pkrish11/PDL-Autoclave-DAQ-PCB/Rev2_AutoclaveDAQ.csv

Reference | Qty | Value | DNP | Exclude from BOM | Exclude from Board | Exclude from Simulation | Exclude from Position Files | Footprint | Datasheet | DigiKey_Part_Number | Quantity
C1,C3,C4 | 3 | 10u |  |  |  |  | ${EXCLUDE_FROM_POS_FILES} | Capacitor_SMD:C_0805_2012Metric | https://mm.digikey.com/Volume0/opasdata/d220001/medias/docus/926/CL_Series_MLCC_ds.pdf | 1276-2872-1-ND | 8
C2,C6,C8,C10,C11,C12 | 6 | 0.1u |  |  |  |  | ${EXCLUDE_FROM_POS_FILES} | Capacitor_SMD:C_0805_2012Metric | https://yageogroup.com/content/datasheet/asset/file/KEM_C1002_X7R_SMD | 399-C0805C104K5RACTUCT-ND | 14
C5,C7,C9 | 3 | 0.22u |  |  |  |  | ${EXCLUDE_FROM_POS_FILES} | Capacitor_SMD:C_0805_2012Metric | https://yageogroup.com/content/datasheet/asset/file/KEM_C1002_X7R_SMD | 399-C0805C224K5RACTUCT-ND | 8
F1,F2 | 2 | Fuseholders |  |  |  |  | ${EXCLUDE_FROM_POS_FILES} | Fuse:Fuseholder_Cylinder-5x20mm_Wuerth_696103101002-SMD_Horizontal_Open | https://www.we-online.com/catalog/datasheet/696108003002.pdf | 732-11376-ND | 5
J1,J6,J7,J8 | 4 | Pressure Sense Connector,RTD1 Connector,RTD2 Connector,RTD3 Connector |  |  |  |  | ${EXCLUDE_FROM_POS_FILES} | Connector_JST:JST_XH_B4B-XH-A_1x04_P2.50mm_Vertical | https://www.jst-mfg.com/product/pdf/eng/eXH.pdf | 455-B4B-XH-A-ND | 10
J2,J3,J4 | 3 | Relay1 Con,Relay2 Con,Relay3 Con |  |  |  |  | ${EXCLUDE_FROM_POS_FILES} | Connector_JST:JST_XH_B3B-XH-A_1x03_P2.50mm_Vertical | https://www.jst-mfg.com/product/pdf/eng/eXH.pdf | 455-2248-ND | 8
J5,J9,J10 | 3 | PowerIn Con,Valve1 PowerCon,Valve2 Power Con |  |  |  |  | ${EXCLUDE_FROM_POS_FILES} | Connector_JST:JST_XH_B2B-XH-A_1x02_P2.50mm_Vertical | https://www.jst-mfg.com/product/pdf/eng/eXH.pdf | 455-B2B-XH-A-ND | 8
PS1 | 1 | R-78K5.0-2.0L |  |  |  |  | ${EXCLUDE_FROM_POS_FILES} | PDL_kicad_footprints:CONV_R-78K5.0-2.0L |  | 945-R-78K5.0-2.0L-ND | 2
R1,R2,R3,R4,R5,R6 | 6 | 10k |  |  |  |  | ${EXCLUDE_FROM_POS_FILES} | Resistor_SMD:R_0805_2012Metric | https://www.seielect.com/catalog/SEI-RMCF_RMCP.pdf | RMCF0805FT10K0CT-ND | 14
R7,R12 | 2 | 100k |  |  |  |  | ${EXCLUDE_FROM_POS_FILES} | Resistor_SMD:R_0805_2012Metric | https://industrial.panasonic.com/cdbs/www-data/pdf/RDM0000/AOA0000C307.pdf | P100KDACT-ND | 6
R8 | 1 | 1k |  |  |  |  | ${EXCLUDE_FROM_POS_FILES} | Resistor_SMD:R_0805_2012Metric | https://www.vishay.com/docs/20035/dcrcwe3.pdf | 541-1.00KCCT-ND | 4
R9,R10,R11 | 3 | 4k |  |  |  |  | ${EXCLUDE_FROM_POS_FILES} | Resistor_SMD:R_0805_2012Metric | https://www.seielect.com/catalog/SEI-RNCF.pdf | 738-RNCF0805BTY4K00CT-ND | 8
S1 | 1 | Crimp Attachments |  |  | Excluded from board | Excluded from simulation | ${EXCLUDE_FROM_POS_FILES} |  | https://www.jst-mfg.com/product/pdf/eng/eXH.pdf | 455-1135TR-ND | 50
S2 | 1 | 3 Pin Adapter |  |  | Excluded from board | Excluded from simulation | ${EXCLUDE_FROM_POS_FILES} |  |  | 455-2219-ND | 10
S3 | 1 | 2 Pin Adapter |  |  | Excluded from board | Excluded from simulation | ${EXCLUDE_FROM_POS_FILES} |  |  | 455-2266-ND | 10
S4 | 1 | 4 Pin Adapter |  |  | Excluded from board | Excluded from simulation | ${EXCLUDE_FROM_POS_FILES} |  |  | 455-2267-ND | 10
U2,U3,U4 | 3 | MAX31865AAP+ |  |  |  |  | ${EXCLUDE_FROM_POS_FILES} | PDL_kicad_footprints:21-0056C_20_MXM-M | MAX31865AAP+ | MAX31865AAP+ | 3
 |  | Num Boards =2
