pkrish11/PDL-Autoclave-DAQ-PCB/Rev2_AutoclaveDAQ.kicad_pcb

## KiCad design Rev2_AutoclaveDAQ.kicad_pcb (2026-11-10)

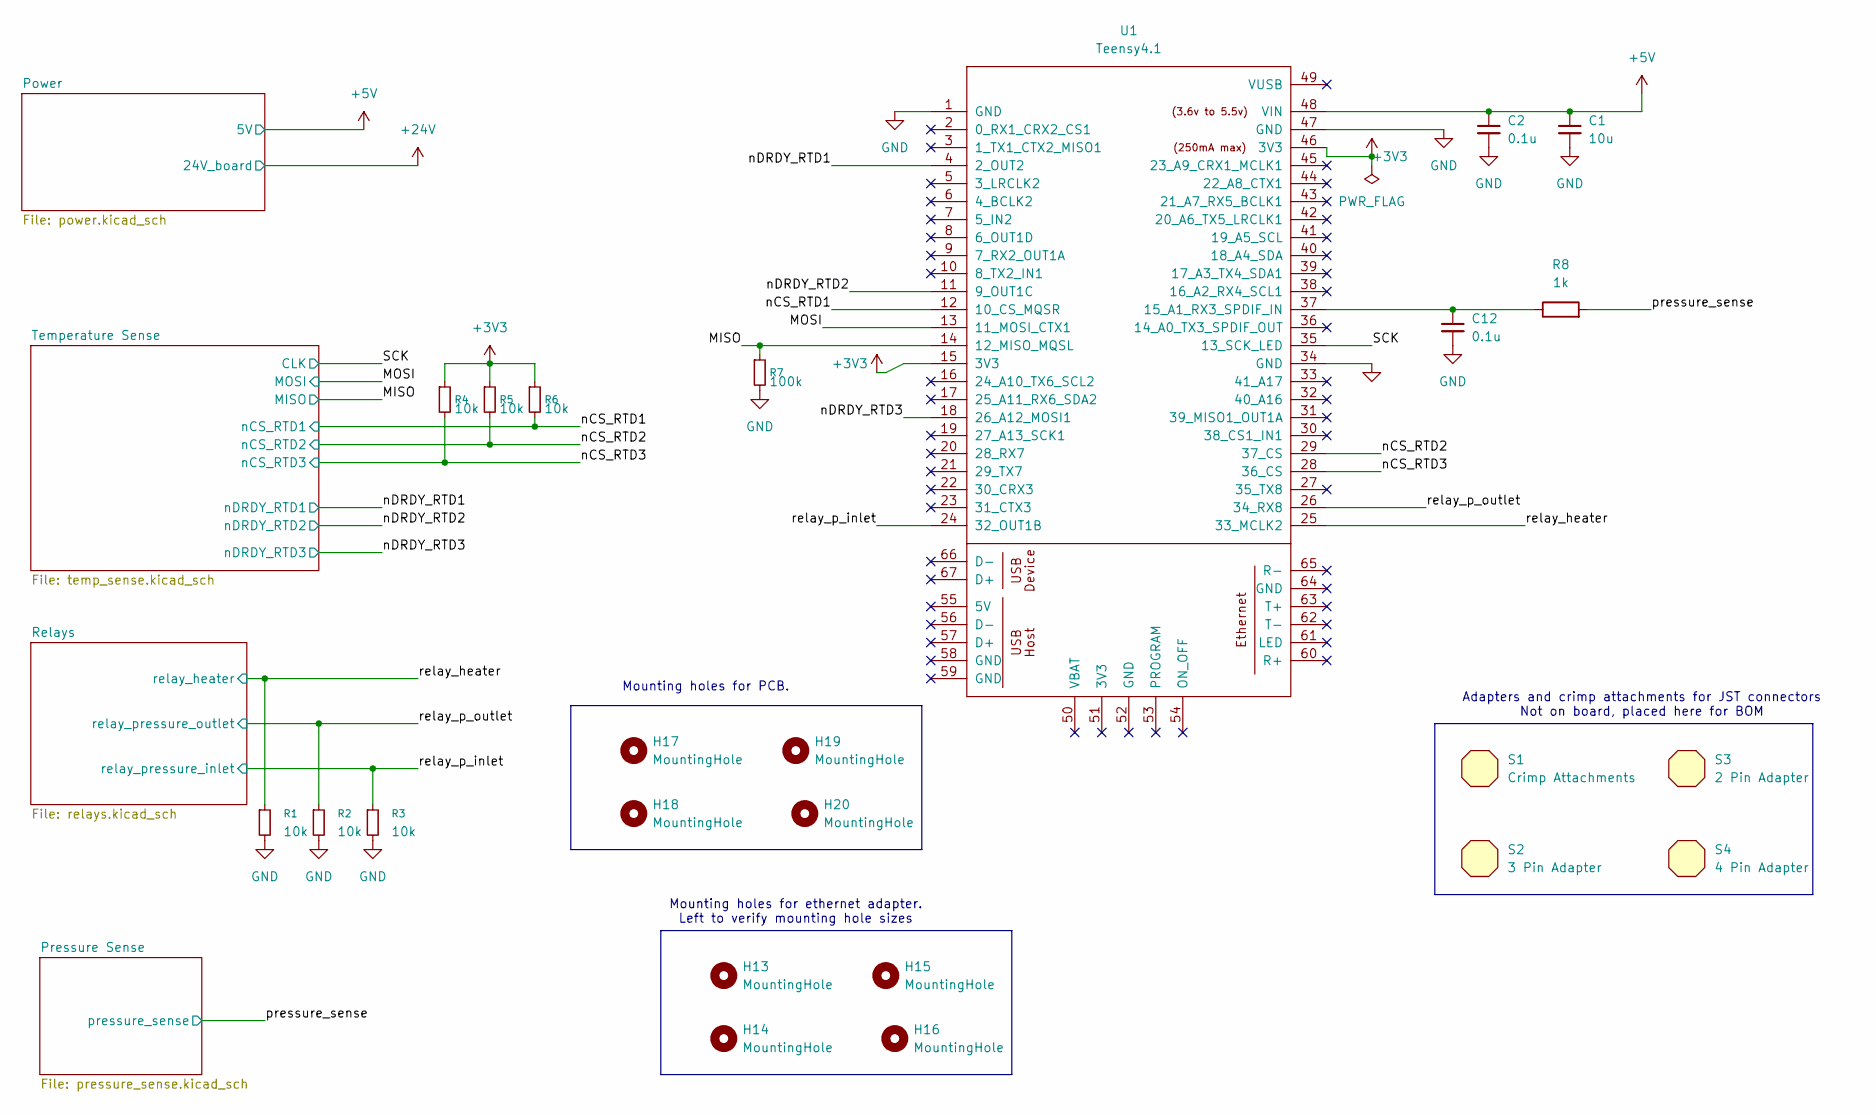
[picture p1: schematic Rev2_AutoclaveDAQ.kicad_sch, Autoclave DAQ Version 2]

Parts:
C1: 10u; C_0805_2012Metric; DigiKey_Part_Number 1276-2872-1-ND
C2, C12: 0.1u; C_0805_2012Metric; DigiKey_Part_Number 399-C0805C104K5RACTUCT-ND
H13, H14, H15, H16, H17, H18, H19, H20: MountingHole; MountingHole_3.2mm_M3
R1, R2, R3, R4, R5, R6: 10k; R_0805_2012Metric; DigiKey_Part_Number RMCF0805FT10K0CT-ND
R7: 100k; R_0805_2012Metric; DigiKey_Part_Number P100KDACT-ND
R8: 1k; R_0805_2012Metric; DigiKey_Part_Number 541-1.00KCCT-ND
S1: Crimp Attachments; DigiKey_Part_Number 455-1135TR-ND
S2: 3 Pin Adapter; DigiKey_Part_Number 455-2219-ND
S3: 2 Pin Adapter; DigiKey_Part_Number 455-2266-ND
S4: 4 Pin Adapter; DigiKey_Part_Number 455-2267-ND
U1: Teensy4.1; Teensy41

Connections:
+3V3: R4.1, R5.1, R6.1, U1.15 (3V3), U1.46 (3V3); also elsewhere on the board
+5V: C1.1, C2.1, U1.48 (VIN); also elsewhere on the board
/MISO: R7.1, U1.14 (12_MISO_MQSL); also elsewhere on the board
/MOSI: U1.13 (11_MOSI_CTX1); also elsewhere on the board
/SCK: U1.35 (13_SCK_LED); also elsewhere on the board
/nCS_RTD1: R6.2, U1.12 (10_CS_MQSR); also elsewhere on the board
/nCS_RTD2: R5.2, U1.29 (37_CS); also elsewhere on the board
/nCS_RTD3: R4.2, U1.28 (36_CS); also elsewhere on the board
/nDRDY_RTD1: U1.4 (2_OUT2); also elsewhere on the board
/nDRDY_RTD2: U1.11 (9_OUT1C); also elsewhere on the board
/nDRDY_RTD3: U1.18 (26_A12_MOSI1); also elsewhere on the board
/pressure_sense: R8.2; also elsewhere on the board
/relay_heater: R1.1, U1.25 (33_MCLK2); also elsewhere on the board
/relay_p_inlet: R3.1, U1.24 (32_OUT1B); also elsewhere on the board
/relay_p_outlet: R2.1, U1.26 (34_RX8); also elsewhere on the board
GND: C1.2, C2.2, C12.2, R1.2, R2.2, R3.2, R7.2, U1.1 (GND), U1.34 (GND), U1.47 (GND); also elsewhere on the board
unnamed: C12.1, R8.1, U1.37 (15_A1_RX3_SPDIF_IN)

Notes on the sheet:
Adapters and crimp attachments for JST connectors Not on board, placed here for BOM
Mounting holes for ethernet adapter. Left to verify mounting hole sizes
Mounting holes for PCB.

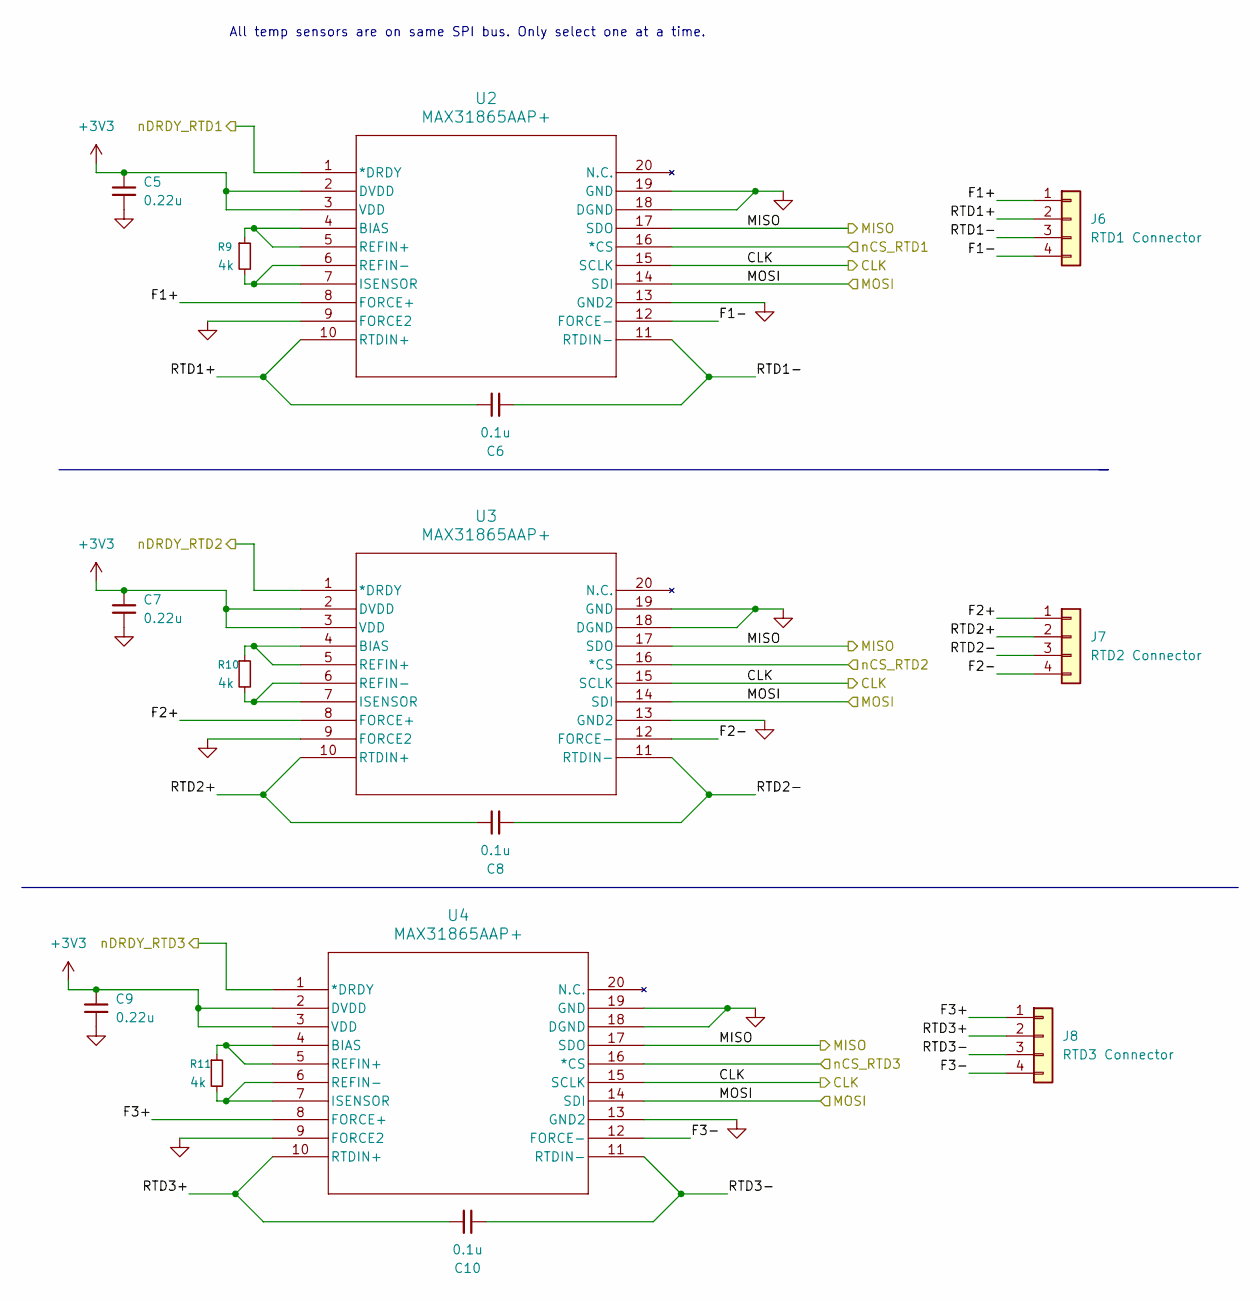
[picture p2: schematic temp_sense.kicad_sch]

Parts:
C5, C7, C9: 0.22u; C_0805_2012Metric; DigiKey_Part_Number 399-C0805C224K5RACTUCT-ND
C6, C8, C10: 0.1u; C_0805_2012Metric; DigiKey_Part_Number 399-C0805C104K5RACTUCT-ND
J6: RTD1 Connector; JST_XH_B4B-XH-A_1x04_P2.50mm_Vertical; DigiKey_Part_Number 455-B4B-XH-A-ND
J7: RTD2 Connector; JST_XH_B4B-XH-A_1x04_P2.50mm_Vertical; DigiKey_Part_Number 455-B4B-XH-A-ND
J8: RTD3 Connector; JST_XH_B4B-XH-A_1x04_P2.50mm_Vertical; DigiKey_Part_Number 455-B4B-XH-A-ND
R9, R10, R11: 4k; R_0805_2012Metric; DigiKey_Part_Number 738-RNCF0805BTY4K00CT-ND
U2, U3, U4: MAX31865AAP+; 21-0056C_20_MXM-M; DigiKey_Part_Number MAX31865AAP+

Connections:
+3V3: C5.1, C7.1, C9.1, U2.2 (DVDD), U2.3 (VDD), U3.2 (DVDD), U3.3 (VDD), U4.2 (DVDD), U4.3 (VDD); also elsewhere on the board
/MISO: U2.17 (SDO), U3.17 (SDO), U4.17 (SDO); also elsewhere on the board
/MOSI: U2.14 (SDI), U3.14 (SDI), U4.14 (SDI); also elsewhere on the board
/SCK: U2.15 (SCLK), U3.15 (SCLK), U4.15 (SCLK); also elsewhere on the board
/Temperature Sense/F1+: J6.1, U2.8 (FORCE+)
/Temperature Sense/F1-: J6.4, U2.12 (FORCE-)
/Temperature Sense/F2+: J7.1, U3.8 (FORCE+)
/Temperature Sense/F2-: J7.4, U3.12 (FORCE-)
/Temperature Sense/F3+: J8.1, U4.8 (FORCE+)
/Temperature Sense/F3-: J8.4, U4.12 (FORCE-)
/Temperature Sense/RTD1+: C6.1, J6.2, U2.10 (RTDIN+)
/Temperature Sense/RTD1-: C6.2, J6.3, U2.11 (RTDIN-)
/Temperature Sense/RTD2+: C8.1, J7.2, U3.10 (RTDIN+)
/Temperature Sense/RTD2-: C8.2, J7.3, U3.11 (RTDIN-)
/Temperature Sense/RTD3+: C10.1, J8.2, U4.10 (RTDIN+)
/Temperature Sense/RTD3-: C10.2, J8.3, U4.11 (RTDIN-)
/nCS_RTD1: U2.16 (*CS); also elsewhere on the board
/nCS_RTD2: U3.16 (*CS); also elsewhere on the board
/nCS_RTD3: U4.16 (*CS); also elsewhere on the board
/nDRDY_RTD1: U2.1 (*DRDY); also elsewhere on the board
/nDRDY_RTD2: U3.1 (*DRDY); also elsewhere on the board
/nDRDY_RTD3: U4.1 (*DRDY); also elsewhere on the board
GND: C5.2, C7.2, C9.2, U2.9 (FORCE2), U2.13 (GND2), U2.18 (DGND), U2.19 (GND), U3.9 (FORCE2), U3.13 (GND2), U3.18 (DGND), U3.19 (GND), U4.9 (FORCE2), U4.13 (GND2), U4.18 (DGND), U4.19 (GND); also elsewhere on the board
unnamed: R9.1, U2.4 (BIAS), U2.5 (REFIN+)
unnamed: R9.2, U2.6 (REFIN-), U2.7 (ISENSOR)
unnamed: R10.1, U3.4 (BIAS), U3.5 (REFIN+)
unnamed: R10.2, U3.6 (REFIN-), U3.7 (ISENSOR)
unnamed: R11.1, U4.4 (BIAS), U4.5 (REFIN+)
unnamed: R11.2, U4.6 (REFIN-), U4.7 (ISENSOR)

Notes on the sheet:
All temp sensors are on same SPI bus. Only select one at a time.

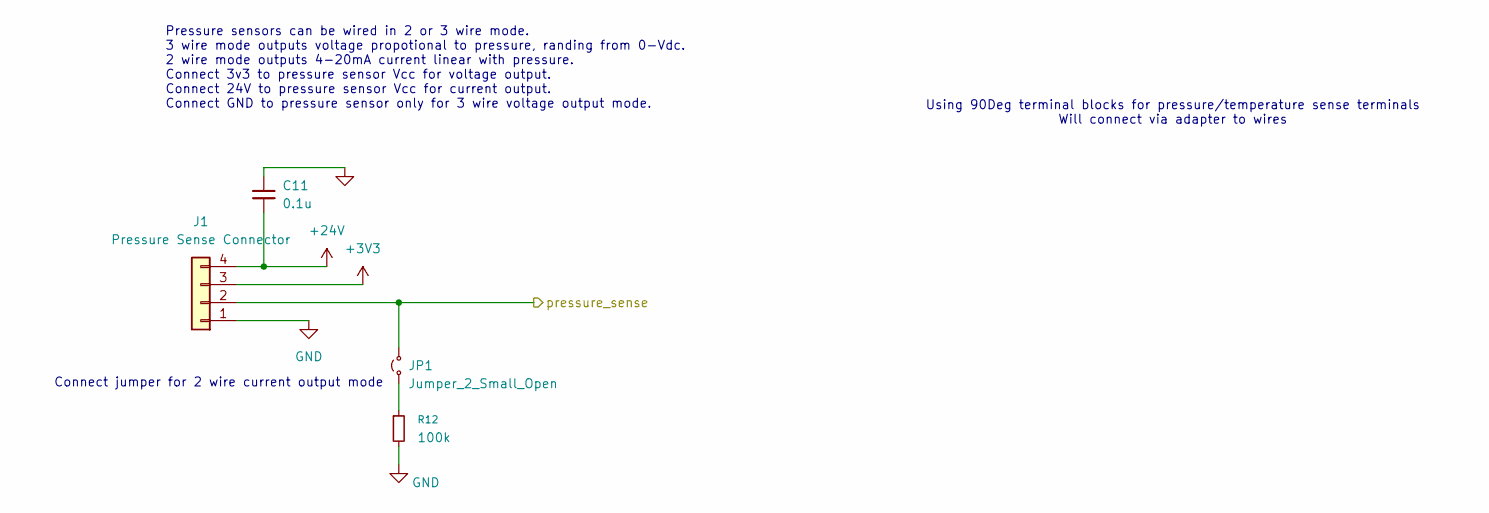
[picture p3: schematic pressure_sense.kicad_sch]

Parts:
C11: 0.1u; C_0805_2012Metric; DigiKey_Part_Number 399-C0805C104K5RACTUCT-ND
J1: Pressure Sense Connector; JST_XH_B4B-XH-A_1x04_P2.50mm_Vertical; DigiKey_Part_Number 455-B4B-XH-A-ND
JP1: Jumper_2_Small_Open; PinHeader_1x02_P2.54mm_Vertical
R12: 100k; R_0805_2012Metric; DigiKey_Part_Number P100KDACT-ND

Connections:
+3V3: J1.3; also elsewhere on the board
+24V: C11.2, J1.4; also elsewhere on the board
/pressure_sense: J1.2, JP1.2 (B); also elsewhere on the board
GND: C11.1, J1.1, R12.2; also elsewhere on the board
unnamed: JP1.1 (A), R12.1

Notes on the sheet:
Connect jumper for 2 wire current output mode
Using 90Deg terminal blocks for pressure/temperature sense terminals Will connect via adapter to wires
Pressure sensors can be wired in 2 or 3 wire mode. 3 wire mode outputs voltage propotional to pressure, randing from 0-Vdc. 2 wire mode outputs 4-20mA current linear with pressure. Connect 3v3 to pressure sensor Vcc for voltage output. Connect 24V to pressure sensor Vcc for current output. Connect 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

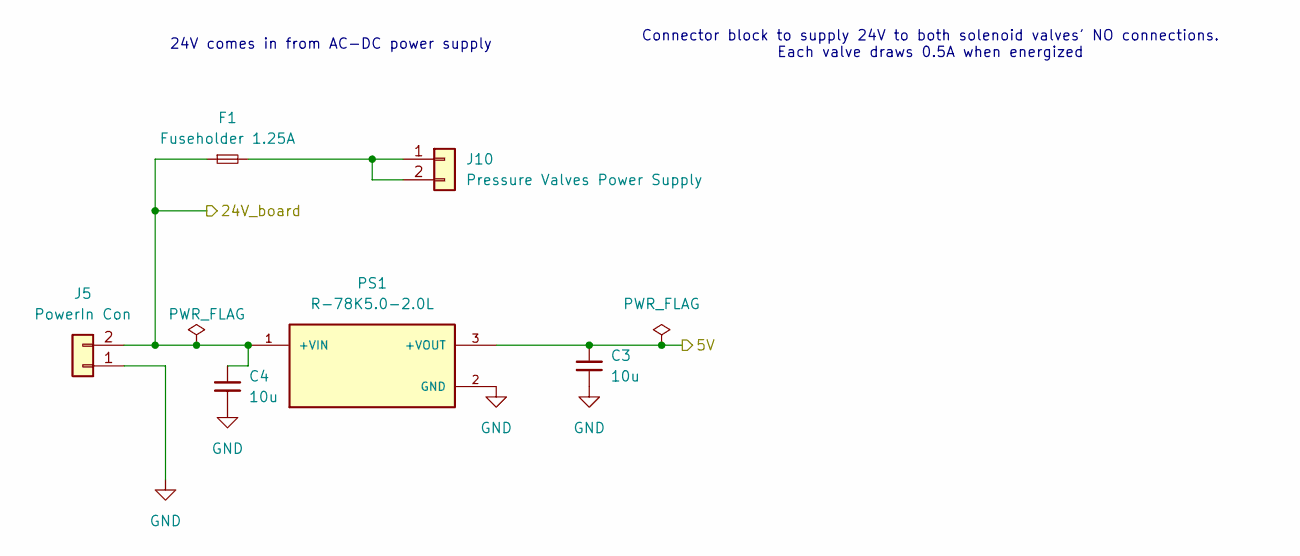
[picture p4: schematic power.kicad_sch]

Parts:
C3, C4: 10u; C_0805_2012Metric; DigiKey_Part_Number 1276-2872-1-ND
F1: Fuseholder 1.25A; Fuseholder_Cylinder-5x20mm_Wuerth_696103101002-SMD_Horizont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; DigiKey_Part_Number 732-11376-ND
J5: PowerIn Con; JST_XH_B2B-XH-A_1x02_P2.50mm_Vertical; DigiKey_Part_Number 455-B2B-XH-A-ND
J10: Pressure Valves Power Supply; JST_XH_B2B-XH-A_1x02_P2.50mm_Vertical; DigiKey_Part_Number 455-B2B-XH-A-ND
PS1: R-78K5.0-2.0L; CONV_R-78K5.0-2.0L; PARTREV 1; DigiKey_Part_Number 945-R-78K5.0-2.0L-ND

Connections:
+5V: C3.1, PS1.3 (+VOUT); also elsewhere on the board
+24V: C4.1, F1.1, J5.2, PS1.1 (+VIN); also elsewhere on the board
GND: C3.2, C4.2, J5.1, PS1.2 (GND); also elsewhere on the board
unnamed: F1.2, J10.1, J10.2

Notes on the sheet:
24V comes in from AC-DC power supply
Connector block to supply 24V to both solenoid valves' NO connections. Each valve draws 0.5A when energized

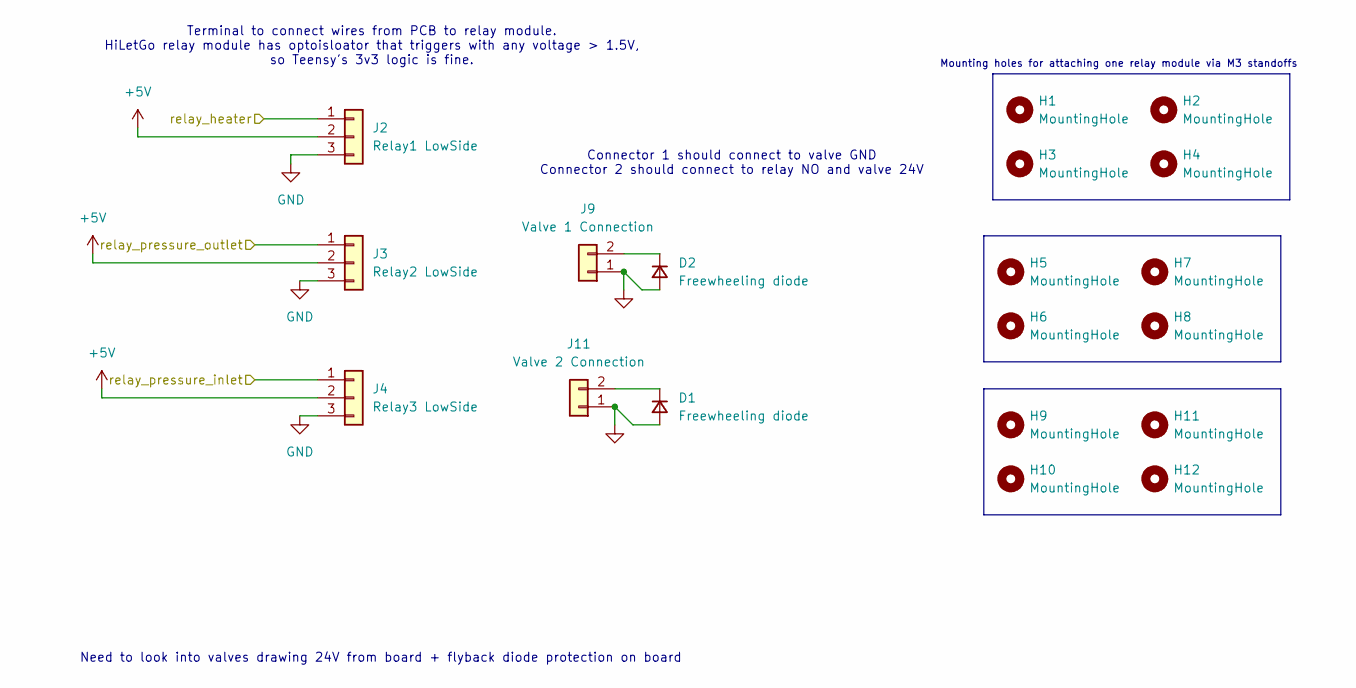
[picture p5: schematic relays.kicad_sch]

Parts:
D1, D2: Freewheeling diode; SMA_403AE_OSI-L
H1, H2, H3, H4, H5, H6, H7, H8, H9, H10, H11, H12: MountingHole; MountingHole_3.2mm_M3
J2: Relay1 LowSide; JST_XH_B3B-XH-A_1x03_P2.50mm_Vertical; DigiKey_Part_Number 455-2248-ND
J3: Relay2 LowSide; JST_XH_B3B-XH-A_1x03_P2.50mm_Vertical; DigiKey_Part_Number 455-2248-ND
J4: Relay3 LowSide; JST_XH_B3B-XH-A_1x03_P2.50mm_Vertical; DigiKey_Part_Number 455-2248-ND
J9: Valve 1 Connection; JST_XH_B2B-XH-A_1x02_P2.50mm_Vertical
J11: Valve 2 Connection; JST_XH_B2B-XH-A_1x02_P2.50mm_Vertical

Connections:
+5V: J2.2, J3.2, J4.2; also elsewhere on the board
/relay_heater: J2.1; also elsewhere on the board
/relay_p_inlet: J4.1; also elsewhere on the board
/relay_p_outlet: J3.1; also elsewhere on the board
GND: D1.2 (A), D2.2 (A), J2.3, J3.3, J4.3, J9.1, J11.1; also elsewhere on the board
unnamed: D1.1 (K), J11.2
unnamed: D2.1 (K), J9.2

Notes on the sheet:
Mounting holes for attaching one relay module via M3 standoffs
Terminal to connect wires from PCB to relay module. HiLetGo relay module has optoisloator that triggers with any voltage > 1.5V, so Teensy's 3v3 logic is fine.
Need to look into valves drawing 24V from board + flyback diode protection on board
Connector 1 should connect to valve GND Connector 2 should connect to relay NO and valve 24V

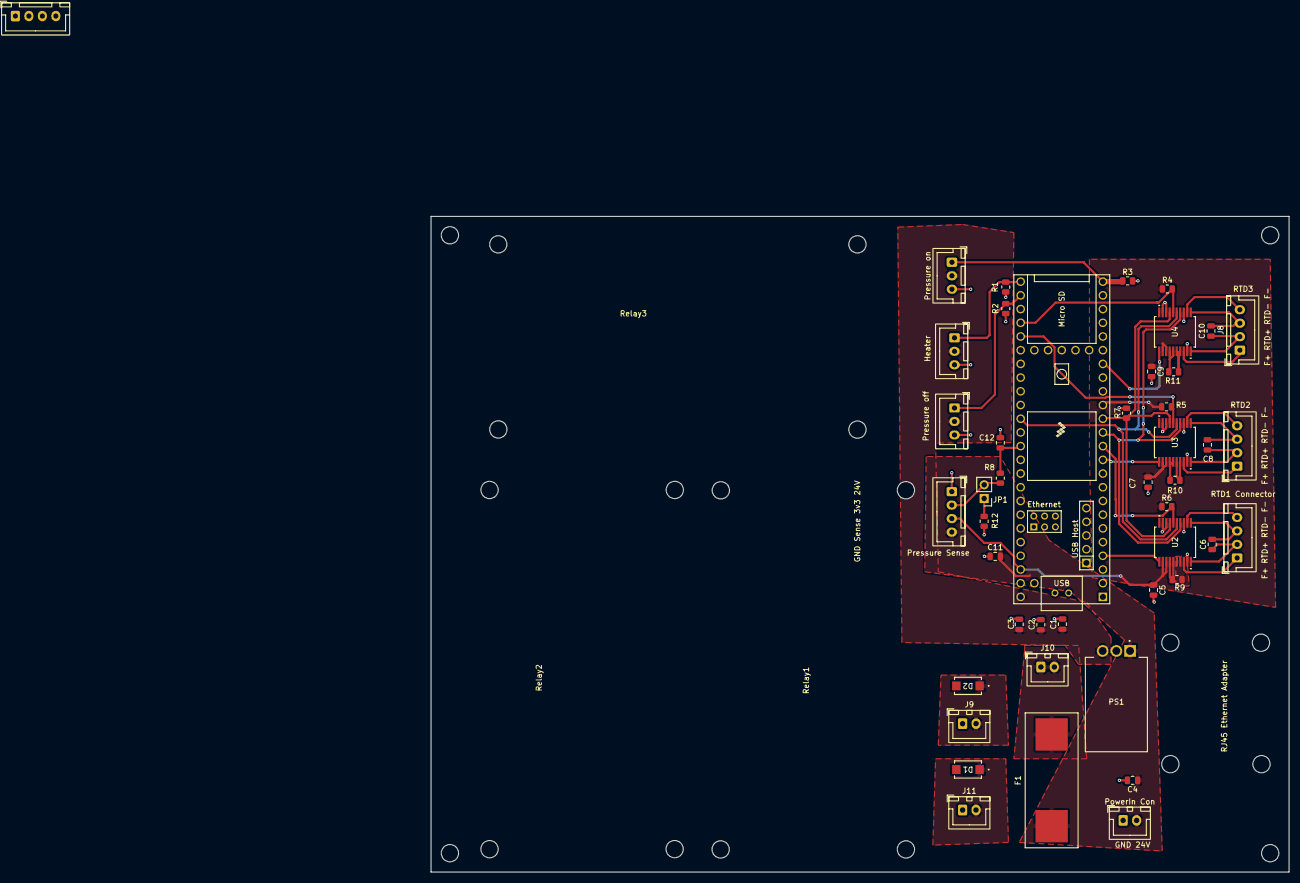
[picture p6: board Rev2_AutoclaveDAQ.kicad_pcb from above]

Board: 2 copper layers, 159.0 x 121.5 mm, 65 parts (0 on the bottom side), 40 nets.

Other parts of the board:
GND Sense 3v3 24V: Pressure Sense; JST_XH_B4B-XH-A_1x04_P2.50mm_Vertical

Their connections:
+3V3: GND Sense 3v3 24V.3; also elsewhere on the board
+24V: GND Sense 3v3 24V.4; also elsewhere on the board
/pressure_sense: GND Sense 3v3 24V.2; also elsewhere on the board
GND: GND Sense 3v3 24V.1; also elsewhere on the board
